Mescalero66/measure-station-python/(commit log)

2026-10-13 UART parser
2026-10-21 add first drivers
2026-10-21 added lux sensor
2026-10-22 add particulate sensor
2026-10-22 added temp sensors
2026-10-22 thread workers
2026-11-03 update fan control
2026-11-03 add kicad schematics WiP
    [MeasureStation.kicad_pcb, MeasureStation.kicad_sch]
2026-11-03 schmatics WIP
    [MeasureStation.kicad_sch]
2026-11-03 update schematics
    [MeasureStation.kicad_sch]
2026-11-05 update fan control logic
2026-11-05 dual fan control
2026-11-11 updated sensor testing
2026-11-11 update default minimum fan run time
